biomec-uma/Pr-tesis.V/firmware/EMG/data/processed/OutputAnalisis/27.10.2026.enReposoSinCricuitoMotoresAlimentacionAislada/figura_3.png

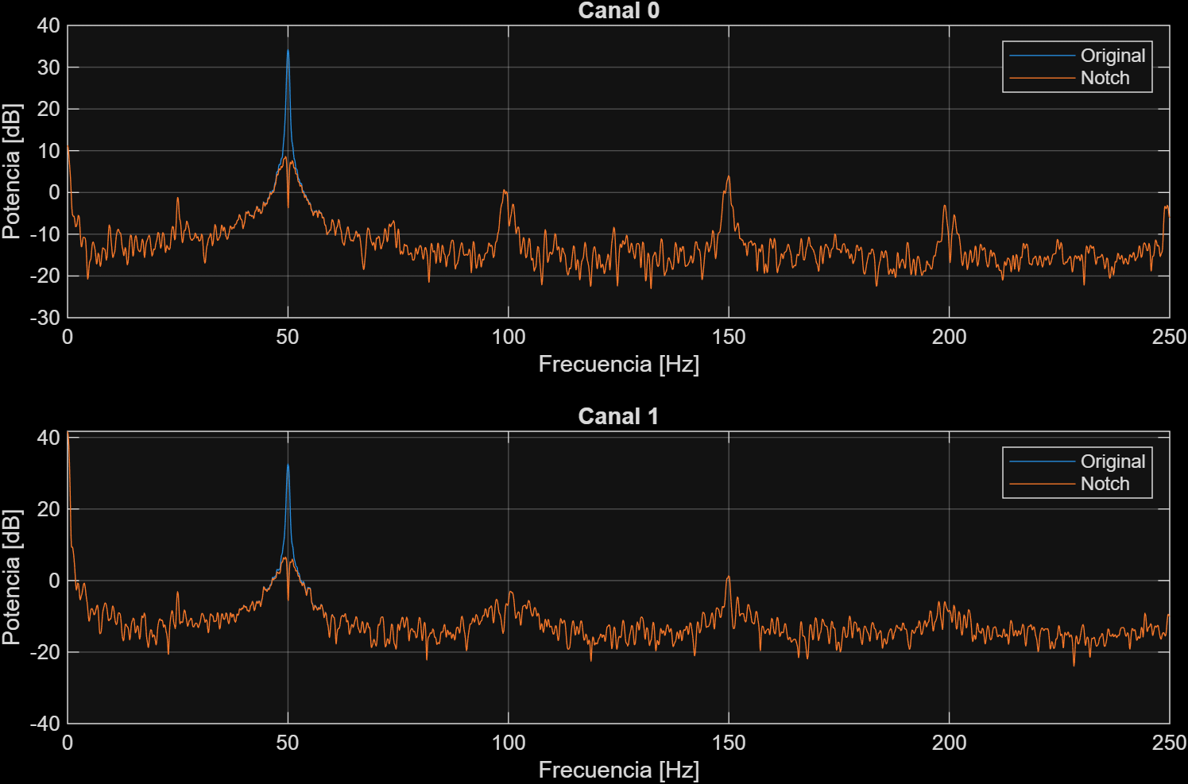
firmware/EMG/data/processed/OutputAnalisis/27.10.2026.enReposoSinCricuitoMotoresAlimentacionAislada/figura_3.png
