biomec-uma/Pr-tesis.V/firmware/EMG/data/processed/OutputAnalisis/27.10.2026.enReposoUsandoMotores/figura_4.png

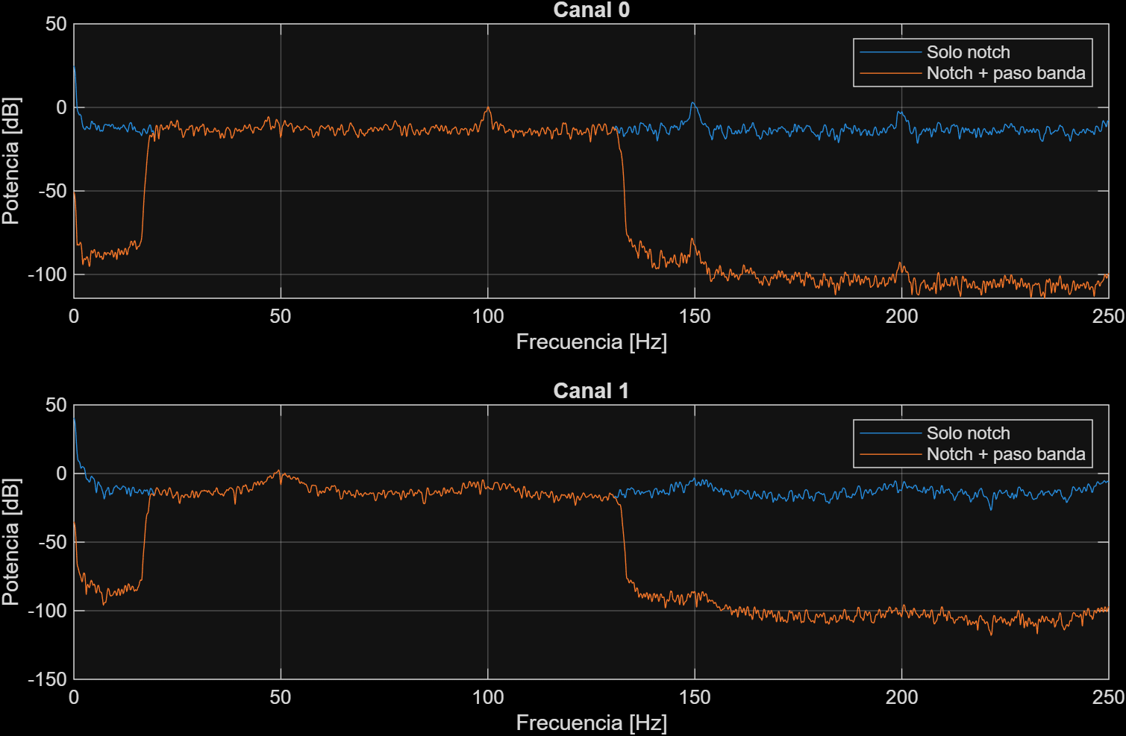
firmware/EMG/data/processed/OutputAnalisis/27.10.2026.enReposoUsandoMotores/figura_4.png
