biomec-uma/Pr-tesis.V/firmware/EMG/data/raw/20.10.2026.antebrazoluegobicep.csvGrafMatlabAnalisisFrec.png

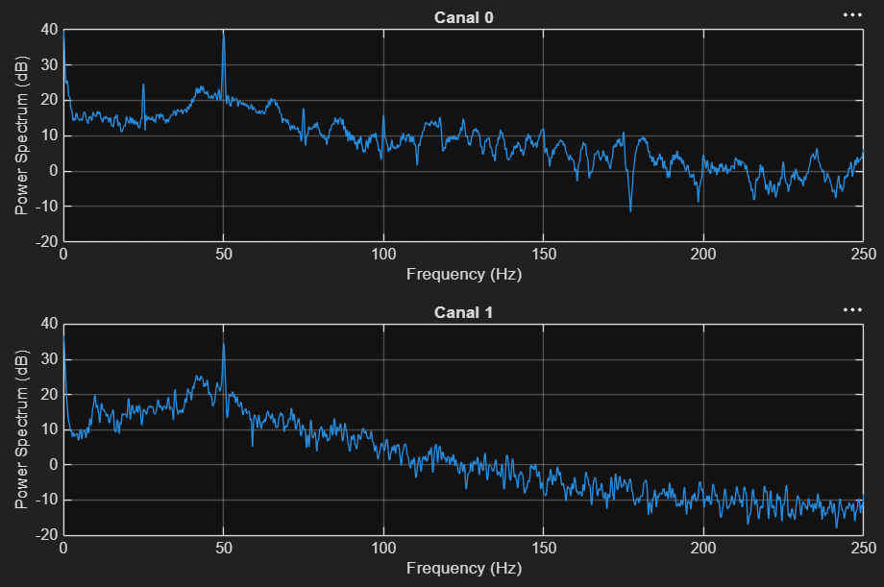
firmware/EMG/data/raw/20.10.2026.antebrazoluegobicep.csvGrafMatlabAnalisisFrec.png
