biomec-uma/Pr-tesis.V/firmware/EMG/data/raw/21.10.2026.antebrazoluegobicep.csvGrafMatlabAnalisisFrec.FiltroNotch.png

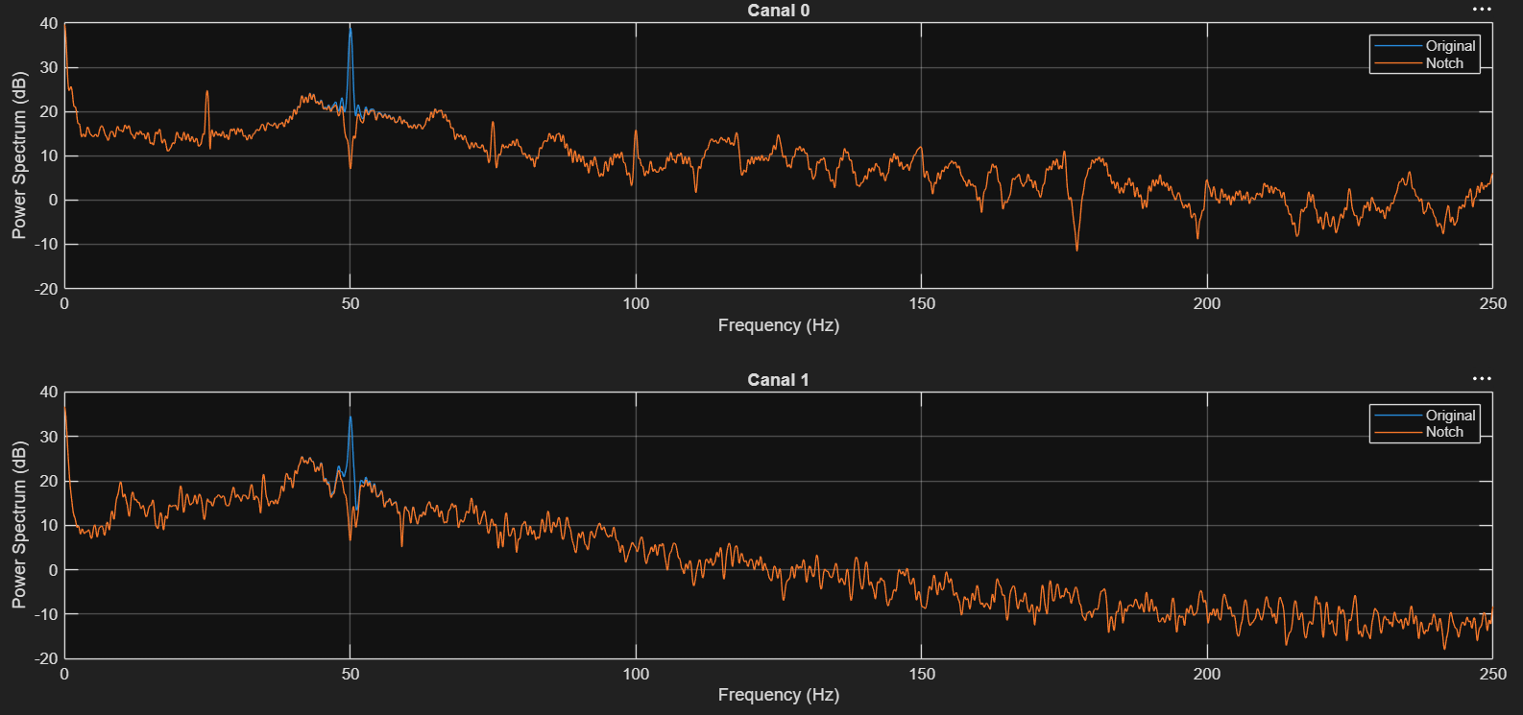
firmware/EMG/data/raw/21.10.2026.antebrazoluegobicep.csvGrafMatlabAnalisisFrec.FiltroNotch.png
