biomec-uma/Pr-tesis.V/firmware/EMG/data/raw/23.10.206.Ruidomotores2.png

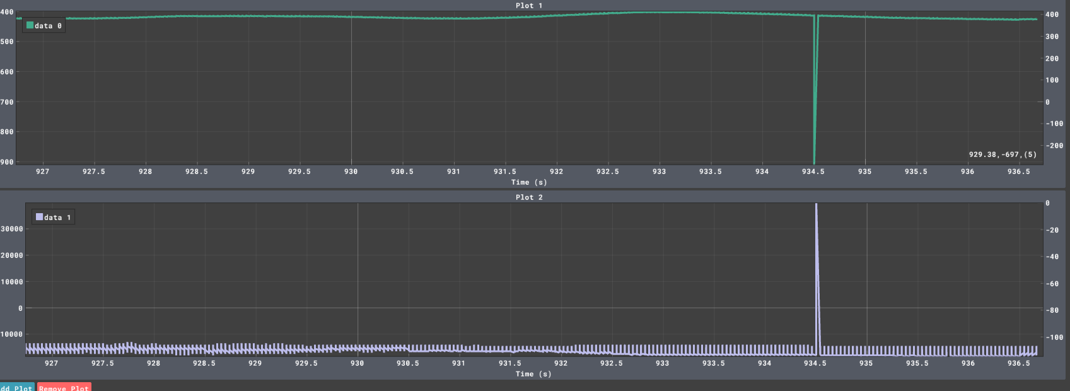
firmware/EMG/data/raw/23.10.206.Ruidomotores2.png
