biomec-uma/Pr-tesis.V/firmware/EMG/data/raw/23.10.2026.Ruidomotores.png

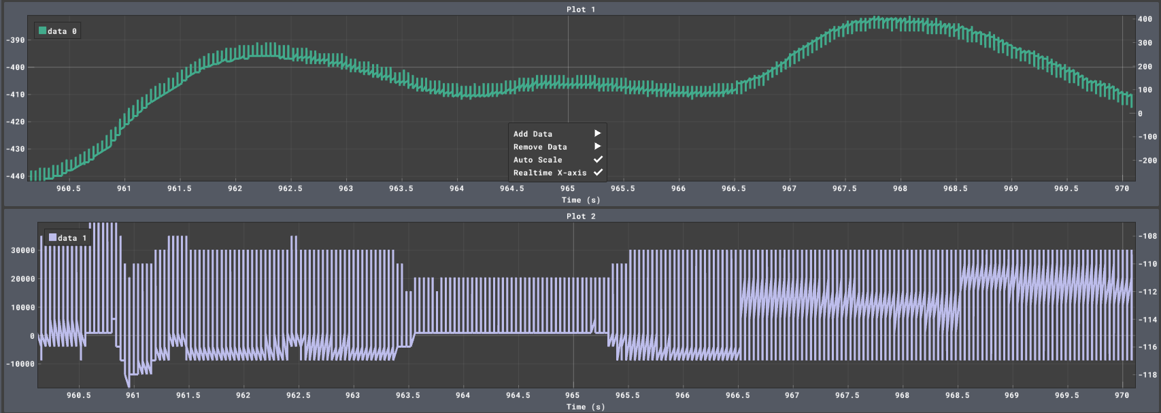
firmware/EMG/data/raw/23.10.2026.Ruidomotores.png
