biomec-uma/Pr-tesis.V/firmware/EMG/data/raw/23.10.2026.Ruidomvtocables.png

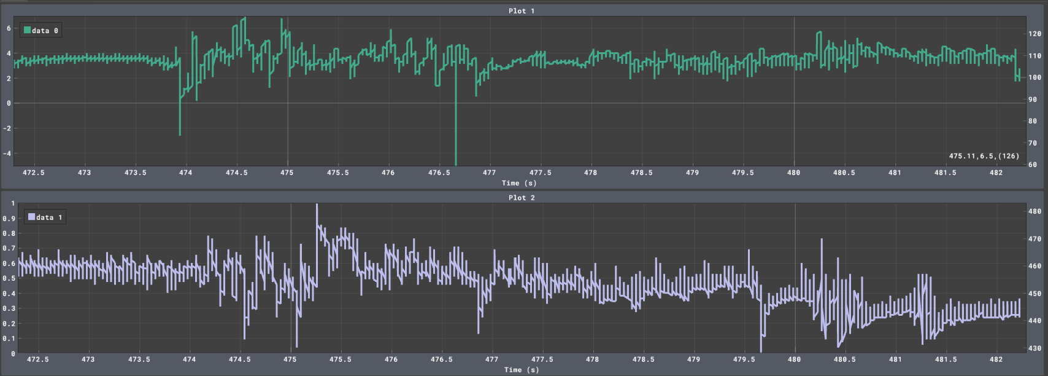
firmware/EMG/data/raw/23.10.2026.Ruidomvtocables.png
