biomec-uma/Pr-tesis.V/firmware/EMG/data/raw/27.10.2026.AisladoSinMotoresHaciendoPulsacionesSeVeClaroSeñalEMG.png

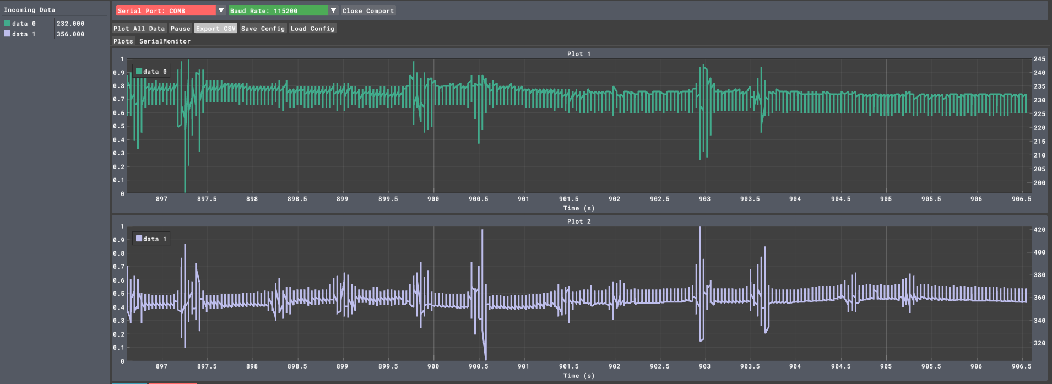
firmware/EMG/data/raw/27.10.2026.AisladoSinMotoresHaciendoPulsacionesSeVeClaroSeñalEMG.png
