biomec-uma/Pr-tesis.V/firmware/EMG/tools/analizadorEMG/tercerScript+app/Azul oscuro + azul claro fondo blanco.png

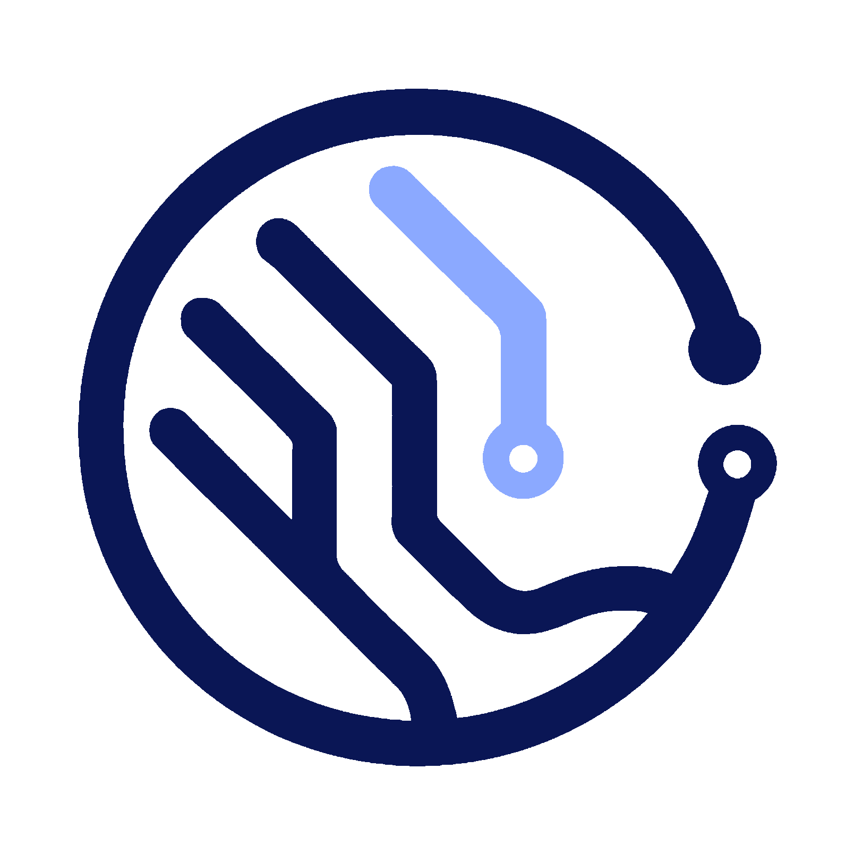
firmware/EMG/tools/analizadorEMG/tercerScript+app/Azul oscuro + azul claro fondo blanco.png
