biomec-uma/Pr-tesis.V/firmware/EMG/tools/analizadorEMG/tercerScript+app/Blanco + azul claro fondo azul oscuro.png

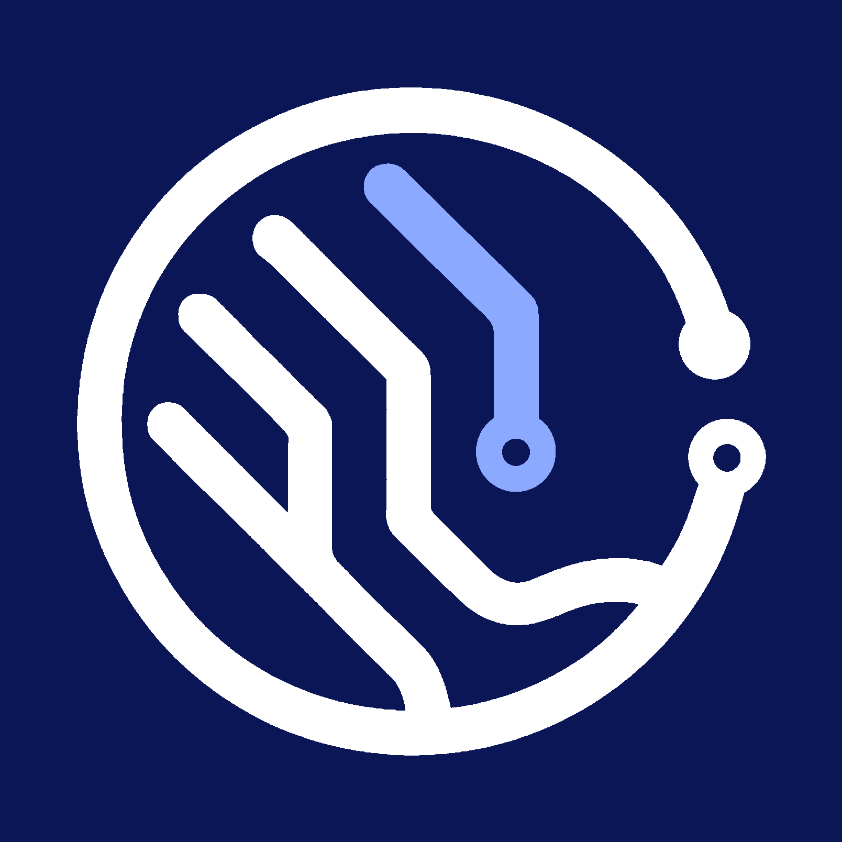
firmware/EMG/tools/analizadorEMG/tercerScript+app/Blanco + azul claro fondo azul oscuro.png
