biomec-uma/Pr-tesis.V/firmware/EMG/tools/analizadorEMG/tercerScript+app/Blanco + azul claro sin fondo.png

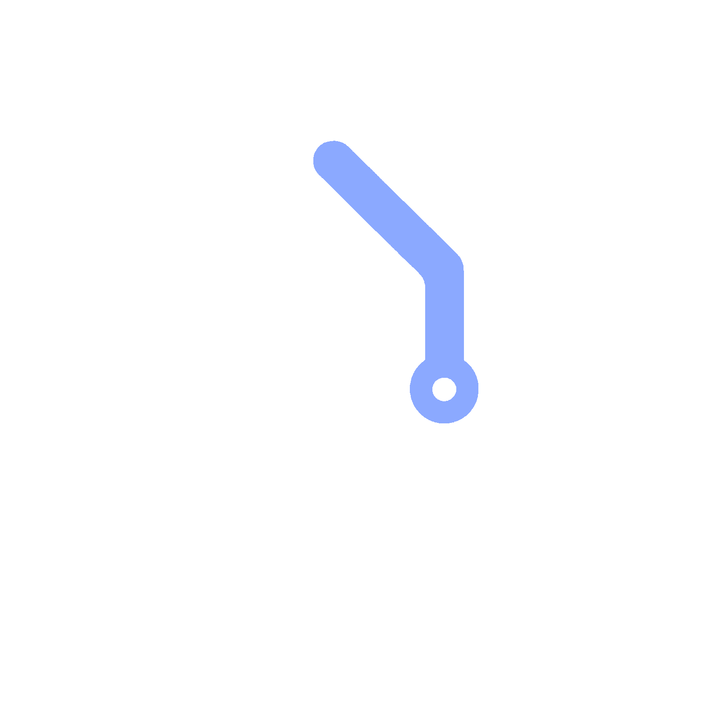
firmware/EMG/tools/analizadorEMG/tercerScript+app/Blanco + azul claro sin fondo.png
