biomec-uma/Pr-tesis.V/firmware/EMG/tools/analizadorEMG/tercerScript+app/miniatura_app.png

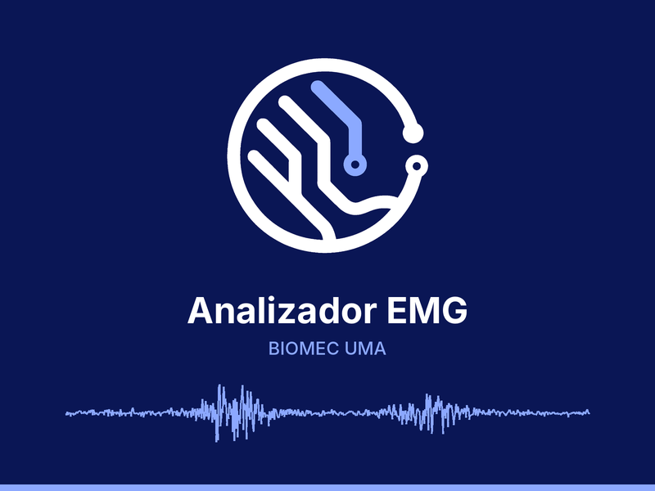
firmware/EMG/tools/analizadorEMG/tercerScript+app/miniatura_app.png
