biomec-uma/Pr-tesis.V/firmware/centro de control/Phyton/codigos phyton/assets/modelo3d/mano - Ensamblaje_DedoV1-2 DistalV1-1.STL

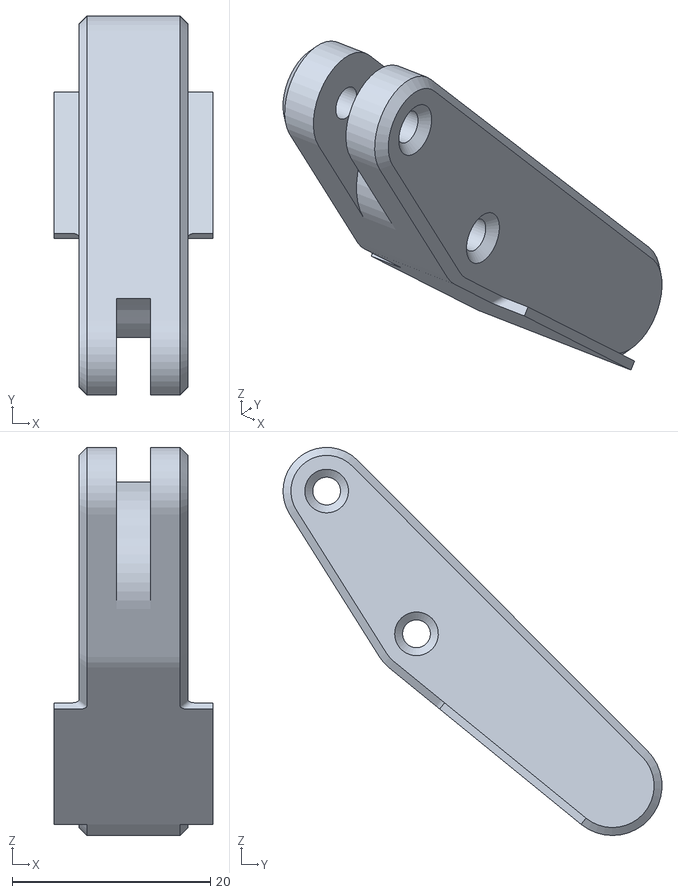
[picture p27: CAD file, 2026-11-08]
firmware/centro de control/Phyton/codigos phyton/assets/modelo3d/mano - Ensamblaje_DedoV1-2 DistalV1-1.STL
16.0 x 38.2 x 39.1
