biomec-uma/Pr-tesis.V/firmware/centro de control/Phyton/codigos phyton/assets/modelo3d/mano - Ensamblaje_DedoV1-1 ProximalV1-1.STL

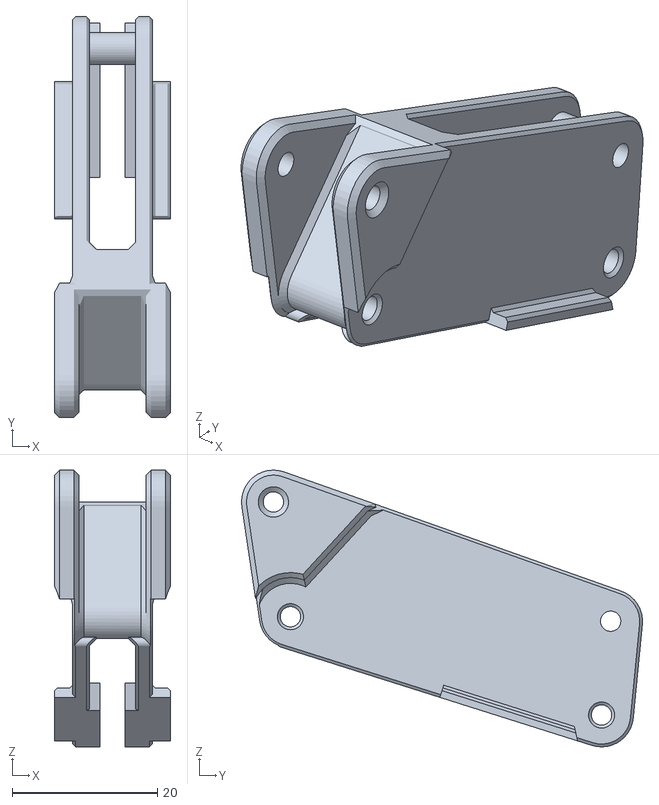
[picture p28: CAD file, 2026-11-08]
firmware/centro de control/Phyton/codigos phyton/assets/modelo3d/mano - Ensamblaje_DedoV1-1 ProximalV1-1.STL
16.0 x 55.3 x 38.2
