biomec-uma/Pr-tesis.V/firmware/centro de control/Phyton/codigos phyton/assets/modelo3d/mano - Ensamblaje_DedoV1-3 Proximal-DistalV1-1.STL

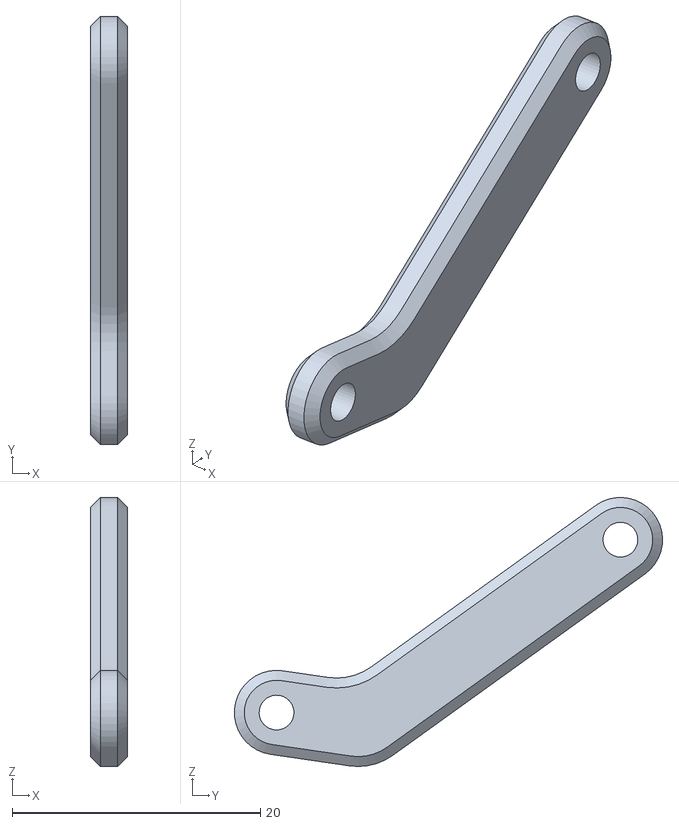
[picture p29: CAD file, 2026-11-08]
firmware/centro de control/Phyton/codigos phyton/assets/modelo3d/mano - Ensamblaje_DedoV1-3 Proximal-DistalV1-1.STL
3.00 x 34.5 x 21.7
