biomec-uma/Pr-tesis.V/firmware/centro de control/Phyton/codigos phyton/assets/modelo3d/mano - Ensamblaje_DedoV1-1 Base-MedioV1-1.STL

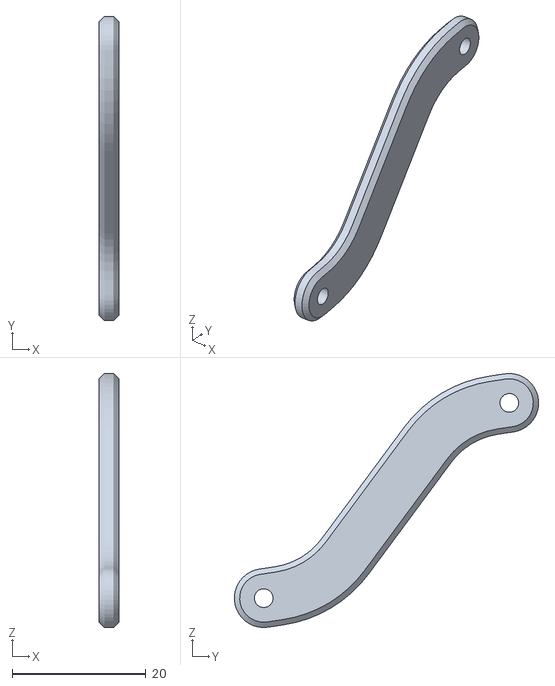
[picture p30: CAD file, 2026-11-08]
firmware/centro de control/Phyton/codigos phyton/assets/modelo3d/mano - Ensamblaje_DedoV1-1 Base-MedioV1-1.STL
3.00 x 45.6 x 38.0
