biomec-uma/Pr-tesis.V/firmware/centro de control/Phyton/codigos phyton/assets/modelo3d/mano - Ensamblaje_DedoV1-3 MedioV1-1.STL

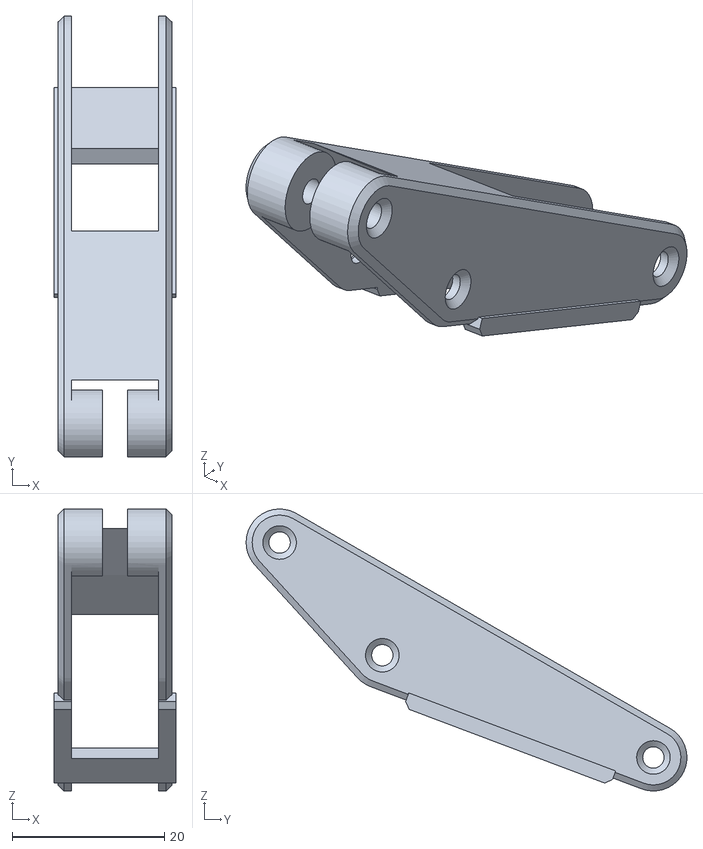
[picture p31: CAD file, 2026-11-08]
firmware/centro de control/Phyton/codigos phyton/assets/modelo3d/mano - Ensamblaje_DedoV1-3 MedioV1-1.STL
16.0 x 57.8 x 37.0
