biomec-uma/Pr-tesis.V/firmware/centro de control/Phyton/codigos phyton/assets/modelo3d/mano - Ensamblaje_DedoV1-1 Proximal-DistalV1-1.STL

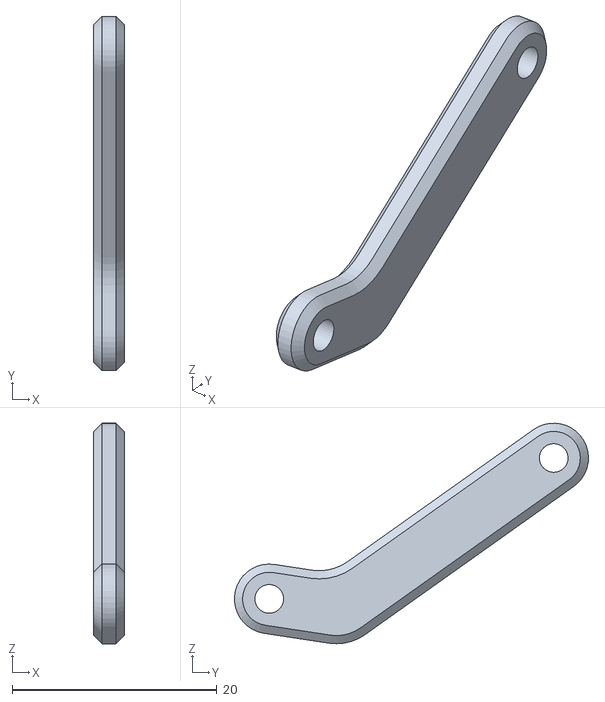
[picture p33: CAD file, 2026-11-08]
firmware/centro de control/Phyton/codigos phyton/assets/modelo3d/mano - Ensamblaje_DedoV1-1 Proximal-DistalV1-1.STL
3.00 x 34.6 x 21.5
