biomec-uma/Pr-tesis.V/firmware/centro de control/Phyton/codigos phyton/assets/modelo3d/mano - PalmaV2-4.STL

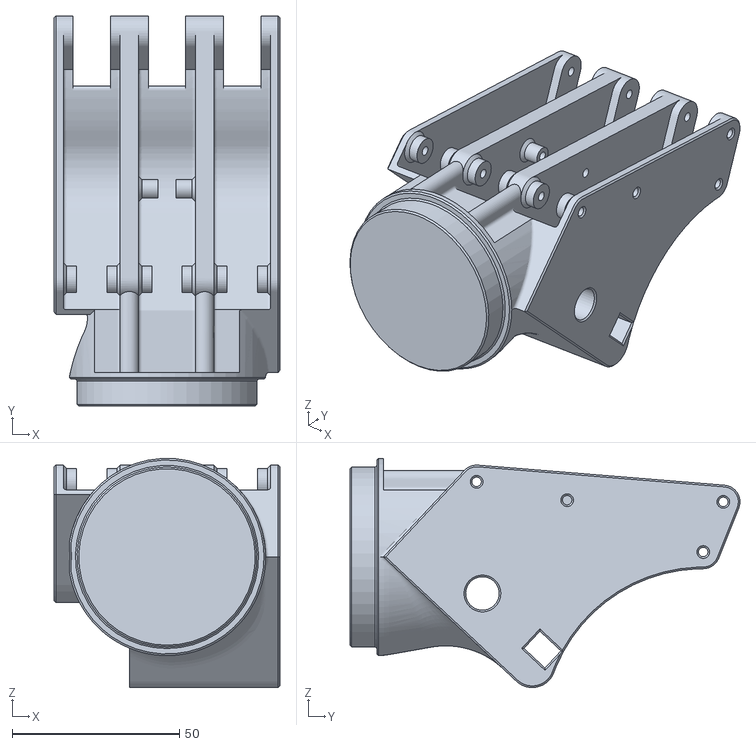
[picture p34: CAD file, 2026-11-08]
firmware/centro de control/Phyton/codigos phyton/assets/modelo3d/mano - PalmaV2-4.STL
67.5 x 116.6 x 68.5
