biomec-uma/Pr-tesis.V/firmware/centro de control/Phyton/codigos phyton/assets/modelo3d/mano - Tapa cables V1.1-1.STL

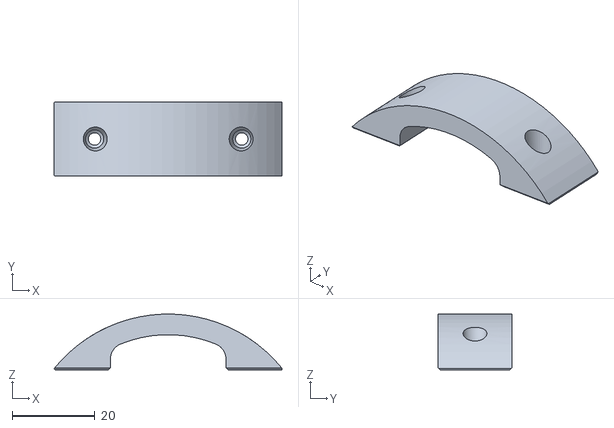
[picture p35: CAD file, 2026-11-08]
firmware/centro de control/Phyton/codigos phyton/assets/modelo3d/mano - Tapa cables V1.1-1.STL
55.2 x 18.0 x 13.5
