biomec-uma/Pr-tesis.V/firmware/centro de control/Phyton/codigos phyton/assets/modelo3d/mano - Pulgar V2-1.STL

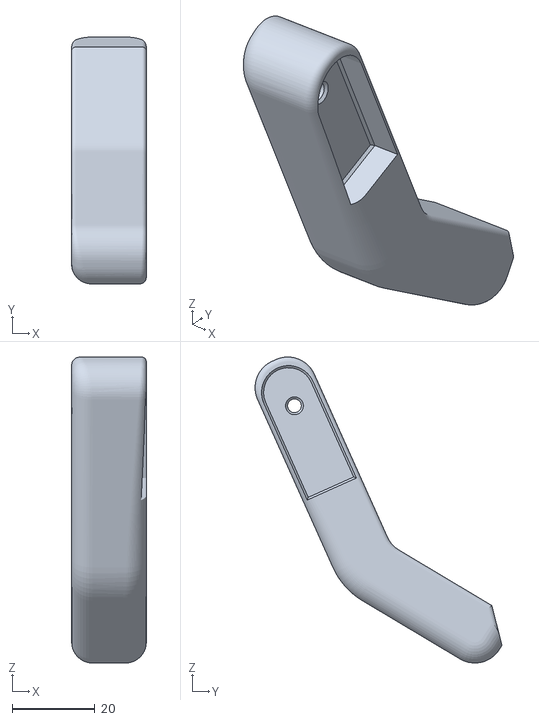
[picture p36: CAD file, 2026-11-08]
firmware/centro de control/Phyton/codigos phyton/assets/modelo3d/mano - Pulgar V2-1.STL
18.0 x 59.5 x 73.8
