biomec-uma/Pr-tesis.V/firmware/EMG/data/processed/OutputAnalisis/23.10.2026.motores/resultados.csv

muestra | nMuestras | duracion_s | p50_ch0 | p50_ch1 | p50notch_ch0 | p50notch_ch1 | rmsReposo_ch0_uV | rmsReposo_ch1_uV | umbral_ch0_uV | umbral_ch1_uV | tRMS_s
23.10.2026.antebrazoluegobicep.motoresypulsacionemg2.csv | 5000 | 10 | 90.0882990676249 | 95.8668968691247 | 10.4064357790879 | 23.7363828783954 | 6.95566996419304 | 7.04175515378349 | 10.8647242165566 | 16.1676572420576 | 0.2
