biomec-uma/Pr-tesis.V/firmware/EMG/data/processed/OutputAnalisis/20.10.2026.antebrazoluegobicep/resultados.csv

muestra | nMuestras | duracion_s | p50_ch0 | p50_ch1 | p50notch_ch0 | p50notch_ch1 | rmsReposo_ch0_uV | rmsReposo_ch1_uV | umbral_ch0_uV | umbral_ch1_uV | tRMS_s
20.10.2026.antebrazoluegobicep.csv | 5000 | 10 | 47.0309302696008 | 31.9491382890656 | 0.680592790414548 | 1.13261666602709 | 24.6298816991616 | 47.0399870246298 | 52.9276194202849 | 74.8116167504218 | 0.2
