biomec-uma/Pr-tesis.V/firmware/EMG/data/processed/OutputAnalisis/23.10.2026.antebrazoluegobicep.alimentaciondirectafuente/resultados.csv

muestra | nMuestras | duracion_s | p50_ch0 | p50_ch1 | p50notch_ch0 | p50notch_ch1 | rmsReposo_ch0_uV | rmsReposo_ch1_uV | umbral_ch0_uV | umbral_ch1_uV | tRMS_s
23.10.2026.antebrazoluegobicep.alimentaciondirectafuente.csv | 5000 | 10 | 22.2796993238099 | 37.5278846168363 | 1.0780974804181 | 1.43304522028347 | 57.2175775108627 | 7.74873480003057 | 192.795387226747 | 15.3363081118244 | 0.2
