biomec-uma/Pr-tesis.V/firmware/EMG/data/processed/OutputAnalisis/23.10.2026.antebrazoluegobicep.alimentaciondirectafuente2/resultados.csv

muestra | nMuestras | duracion_s | p50_ch0 | p50_ch1 | p50notch_ch0 | p50notch_ch1 | rmsReposo_ch0_uV | rmsReposo_ch1_uV | umbral_ch0_uV | umbral_ch1_uV | tRMS_s
23.10.2026.antebrazoluegobicep.alimentaciondirectafuente2.csv | 5000 | 10 | 19.0085972044164 | 72.9052320779621 | 0.341583894961265 | 1.67181172224506 | 56.2505791040427 | 15.7602501629579 | 221.067460242114 | 56.7988829818289 | 0.2
