biomec-uma/Pr-tesis.V/(commit log)

2026-10-17 Limpieza de git.keep
2026-10-17 Cambio de nombre a uno formal y añadida la librería BIOMEC_ADS119X.h
2026-10-18 codigo limpio y listo para usarse en vscode
2026-10-18 Añadida la librería documentada
2026-10-18 borré variables que no se usaban del ADS pero que estaban simplemente comentadas. cambié el tipo de if en print data que compara si todo el registro es 0 aumulando hasta 750 ceros a un if clásico ya 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
2026-10-18 -variables del ads sobrantes retiradas. -Creada funcion que imprime paquetes cada x muestras para no saturar al micro -Ahora el esp32 en el bucle pide muestra solo si el ADS manda un 1 a dataready de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
2026-10-19 Comentario añadido sobre la funcion nueva Nuevos datos con codigo limpio Video del serial plotter
2026-10-19 Nuevo codigo para ESP32 C6. Compila pero no se si cargará en el C6 debido a que no se si la configuración en el .ini es la apropiada. Añadido readme de como hice para que pudiera compilar el C6 en vs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
2026-10-20 Video añadido usando ESPNOW imprime desde C6, revisar que el codigo de toma de datos es correcto, parece que responde a mi antebrazo y luego la bicep. Se nota mejora en respuesta ante una contracción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
2026-10-20 añado .md donde se explica como se debe configurar el IDE para usar los C6
2026-10-20 Se han exportado los valores tomados el día 20 crudos desde el C6 y se ha graficado en MATLAB, posteriormente se ha hecho un análisis en el dominio de la frecuencia. Se ha cuantizado el efecto en % d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
2026-10-20 imagen análisis en el dominio de la frecuencia
2026-10-23 Nuevas muestras EMG. Se han obtenido resultados revelantes: A pesar de estar en un circuito aislado se recibe ruido desde el circuito de potencia al de adquisición de datos. Los cables como se predij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
    También se han añadido imágenes de un filtro notch hecho con matlab, se seguirá haciendo el analisis de frecuencias y comparando muestras para ver exactamente que más frecuencias debemos filtrar.
2026-10-25 script herramienta para analizar señales con matlab terminado. Ahora es más fácil analizar muestras csv ejecutando el script Se añaden más datos procesados
2026-10-25 Script de herramienta para analizar señales terminado
2026-10-27 app para EMG
2026-11-03 subida de codigos
2026-11-03 cambios de carpetas
2026-11-08 Centro de control: simulador, Mano 3D y firmware de la mano corregido
    - App: simulador de puente + mano (opción SIMULADOR) para trabajar sin
    hardware, y pestaña Mano 3D con el ensamblaje de SolidWorks (STL)
    animado: mecanismo de barras de cada dedo y pulgar en pinza.
    - Gráficas: corregida la etiqueta que cortaba valores negativos.
    - mano.ino: al interrumpir un movimiento, los motores frenan desde su
    velocidad actual en vez de saltar a PWM 255.
    - README: normas del equipo y ubicación de cada parte en este repo.
    Aún sin probar con el hardware real.
2026-11-08 Centro de control v0.2: Entrenamiento (EMG), control por voz, asistente IA, posturas y sesiones
    App (firmware/centro de control/Phyton/codigos phyton):
    - Entrenamiento: control con los músculos (EMG). Filtros, características
    de Hudgins y LDA, decisión en tiempo real y exportación del modelo a C
    para la ESP32. Paciente virtual para probar sin la placa.
    - Control por voz sin internet (Vosk): órdenes cerradas y «para» siempre activo.
    - Asistente IA con Claude: diagnostica y propone comandos, que solo se
    envían al pulsar Ejecutar.
    - Mis posturas, grabar y reproducir sesiones, e interfaz renovada.
    - 49 pruebas automáticas; la de coherencia con el firmware lo busca en maestro/.
    Fi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
2026-11-12 Firmware del centro de control: el puente funciona con y sin la placa EMG
    - c6/puente_pc.ino: además de puente de la mano, si la placa EMG (ADS1198) está encendida reenvía
    al PC su señal con el formato nuevo del sensor (rama Imprimir-seq), en los mismos marcos AA 55 que
    el receptor del equipo (tipo 0x01 datos, 0x02 estado de la C6 cada segundo mientras llega EMG).
    Sigue entendiendo el formato antiguo (main) como líneas EMG de texto. Sin placa EMG solo hay texto.
    Vale para la DevKitC del puente y para la C6-Zero del receptor. LED azul mientras llega EMG.
    @EMG 0/1 lo apaga/enciende y @INFO dice si llega (sensor=si/no), el formato y los contadores.
    - mano/mano.ino: motores con le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
2026-11-12 Centro de control v0.6.0 y firmware en .cpp (PlatformIO)
    Firmware (firmware/centro de control/maestro/):
    - c6/, mano/ y bucle_exposiciones/ pasan de .ino a proyectos de PlatformIO: platformio.ini
    (pioarduino 54.03.21 = core Arduino 3.x) + src/<nombre>.cpp + include/. Se abre la carpeta en
    VS Code y se sube. El puente tiene dos entornos: devkitc (DevKitC del puente) y c6zero (C6-Zero
    del receptor del equipo, mismos ajustes de placa que maestro/platformio.ini).
    - No se toca maestro/src/main.cpp ni maestro/platformio.ini (receptor EMG del equipo).
    App (Phyton/codigos phyton), de la v0.2 a la v0.6.0 (detalle en CHANGELOG.md):
    - 0.3: instalador de Windows y actualizaciones desde GitHub Rel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
